ytr0/opensusi-tr10-inverter/(commit log)

2026-09-21 TR-1um CMOS inverter: schematic, layout generator, DRC/LVS/post-layout flow
    - inverter.sch / sim.sch: schematic and DC testbench (PMOS W=8.2um for Vinv=VDD/2)
    - postlayout/gen_inverter_layout.py: layout from PDK PCells, N-well sized from DRC rules
    - postlayout/run.sh: DRC -> LVS -> schematic/layout simulation comparison
    - art_ytr0: floating M2 silicon art (DRC/LVS clean)
    [inverter.sch, main.sch, sim.sch]
2026-09-21 Add temperature sensor block and inverter_only/full variants
    - ytr0_inverter / ytr0_tempsens / art_ytr0 as separate cells under ytr0_top
    - tempsens: 9x DP diodes (1 + 8 parallel, 1D common centroid), N-well cathode to VSS, M2 light shield
    - power rails live in ytr0_top so deleting ytr0_tempsens cannot break the inverter
    - layout/gen_layout.py takes -rd variant=inverter_only|full
    - check.sh: layout -> DRC -> LVS for every variant (both: DRC 0, LVS match)
    [ytr0_inverter.sch, ytr0_tempsens.sch, ytr0_top.sch]
2026-09-21 Add full-variant layout image and temperature sweep testbench
2026-09-21 Replace temperature sensor with a 1-bit SRAM in the full variant
    - ytr0_sram: cross-coupled inverters + transmission gate (WORD inverted on chip)
    - variants: inverter_only / full (inverter + SRAM) / sram_only
    - all variants: DRC 0 violations, LVS match
    - simulated on the LVS-matched netlist: write 0<->1, hold, non-destructive read
    into a 10pF pad, and no interference with the inverter
    - tempsens block kept in the repo but not instantiated in any variant
    [ytr0_sram.sch, ytr0_top.sch]
2026-09-21 Bring all pins out to pads on the block boundary
    - signals escape to the edge: A (left, M1), Q and WORD (bottom, M2), DATA (right, M1)
    - 5um landing pads with labels; power rails now span the full width with pads
    on both ends so the integrator can daisy-chain VDD/VSS with other blocks
    - prBoundary added
    - all variants still DRC 0 / LVS match; PINLIST.md updated with pad coordinates
